GaudiLabs/OpenDropVersatileModulAdapter/README.md

# OpenDropVersatileModulAdapter
Module Adapter for OpenDrop V4 with break out connectors for I2C signals and extra pads on the cartridge
