GaudiLabs/OpenDropVersatileModulAdapter/(commit log)

2020-10-26 First Upload
    [ModulAdapter-2019-04-11-17-09-46.sch, ModulAdapter_Verv.csv, ModulAdapter_Verv.sch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]
2020-10-28 Removed vias from pads and moved HV data line
    [ModulAdapter_Verv2.kicad_pcb]
2020-10-28 Updated Wiring to avoid screw hole
    [ModulAdapter_Verv2.kicad_pcb]
2020-10-28 removed trace under screw, labled connector
    [ModulAdapter_Verv2-B.Cu.gbr, ModulAdapter_Verv2-B.Mask.gbr, ModulAdapter_Verv2-B.Paste.gbr, ModulAdapter_Verv2-B.SilkS.gbr, ModulAdapter_Verv2-Edge.Cuts.gbr, ModulAdapter_Verv2-F.Cu.gbr, ModulAdapter_Verv2-F.Mask.gbr, ModulAdapter_Verv2-F.Paste.gbr]
